pnsn/mcEmeter/IMG_4341.JPG

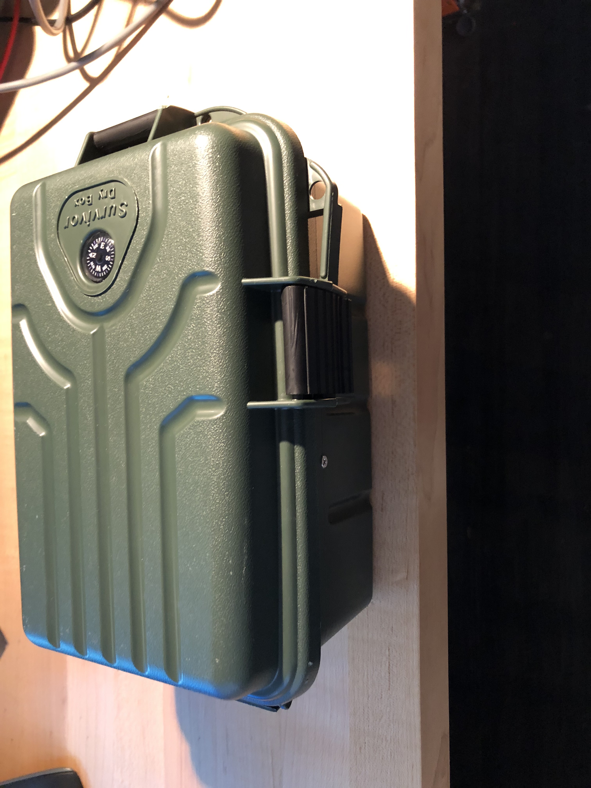
IMG_4341.JPG
