pnsn/mcEmeter/IMG_4349.JPG

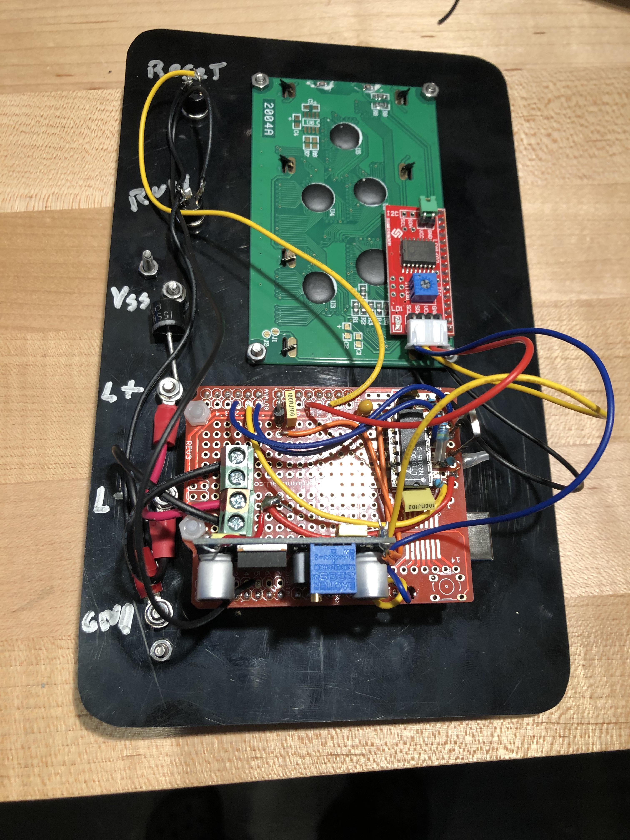
IMG_4349.JPG
