pnsn/mcEmeter/mcemeter_plate.pdf

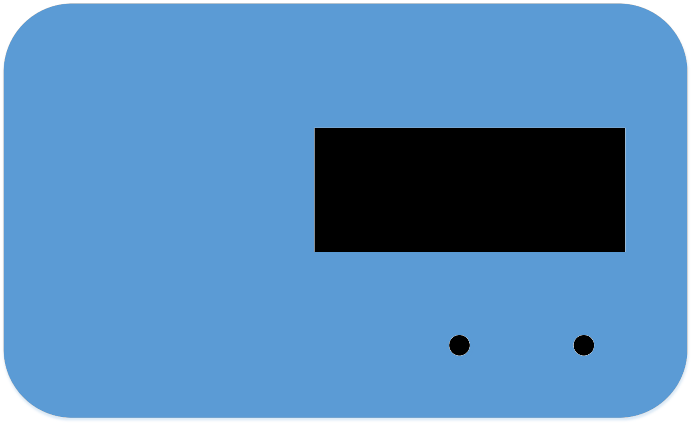
[picture p5: figure]
