pnsn/mcEmeter/IMG_4340.JPG

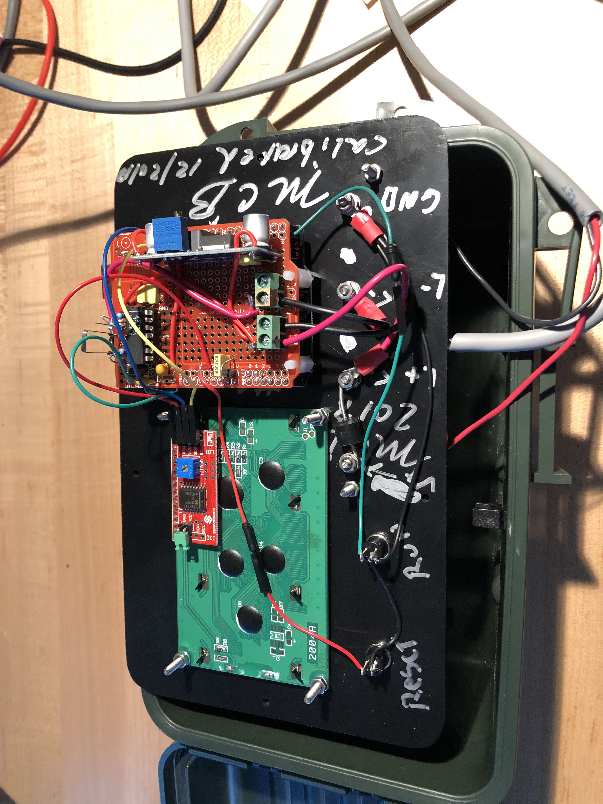
IMG_4340.JPG
