pnsn/mcEmeter/IMG_4350.JPG

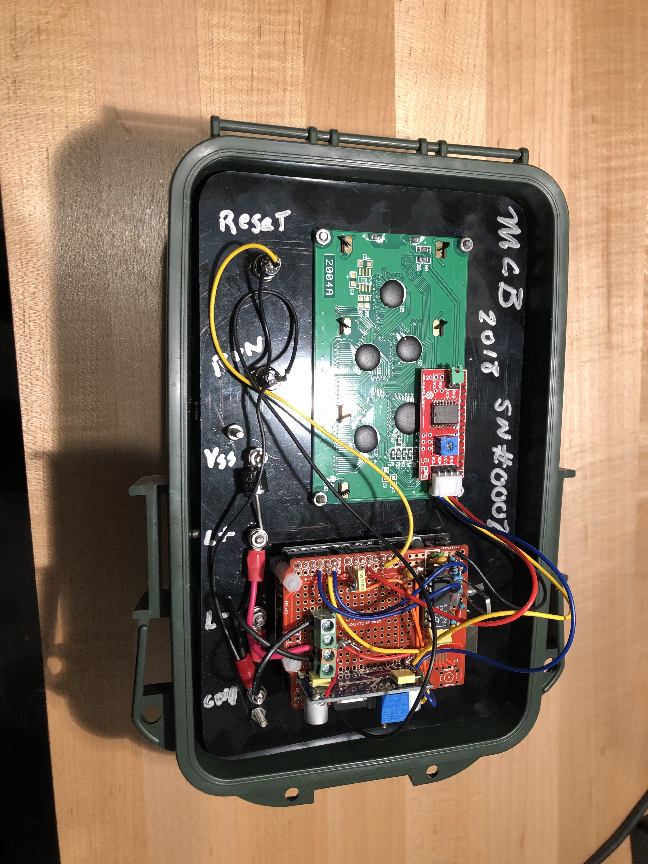
IMG_4350.JPG
