pnsn/mcEmeter/mcemeter_Rev1.0.bmp

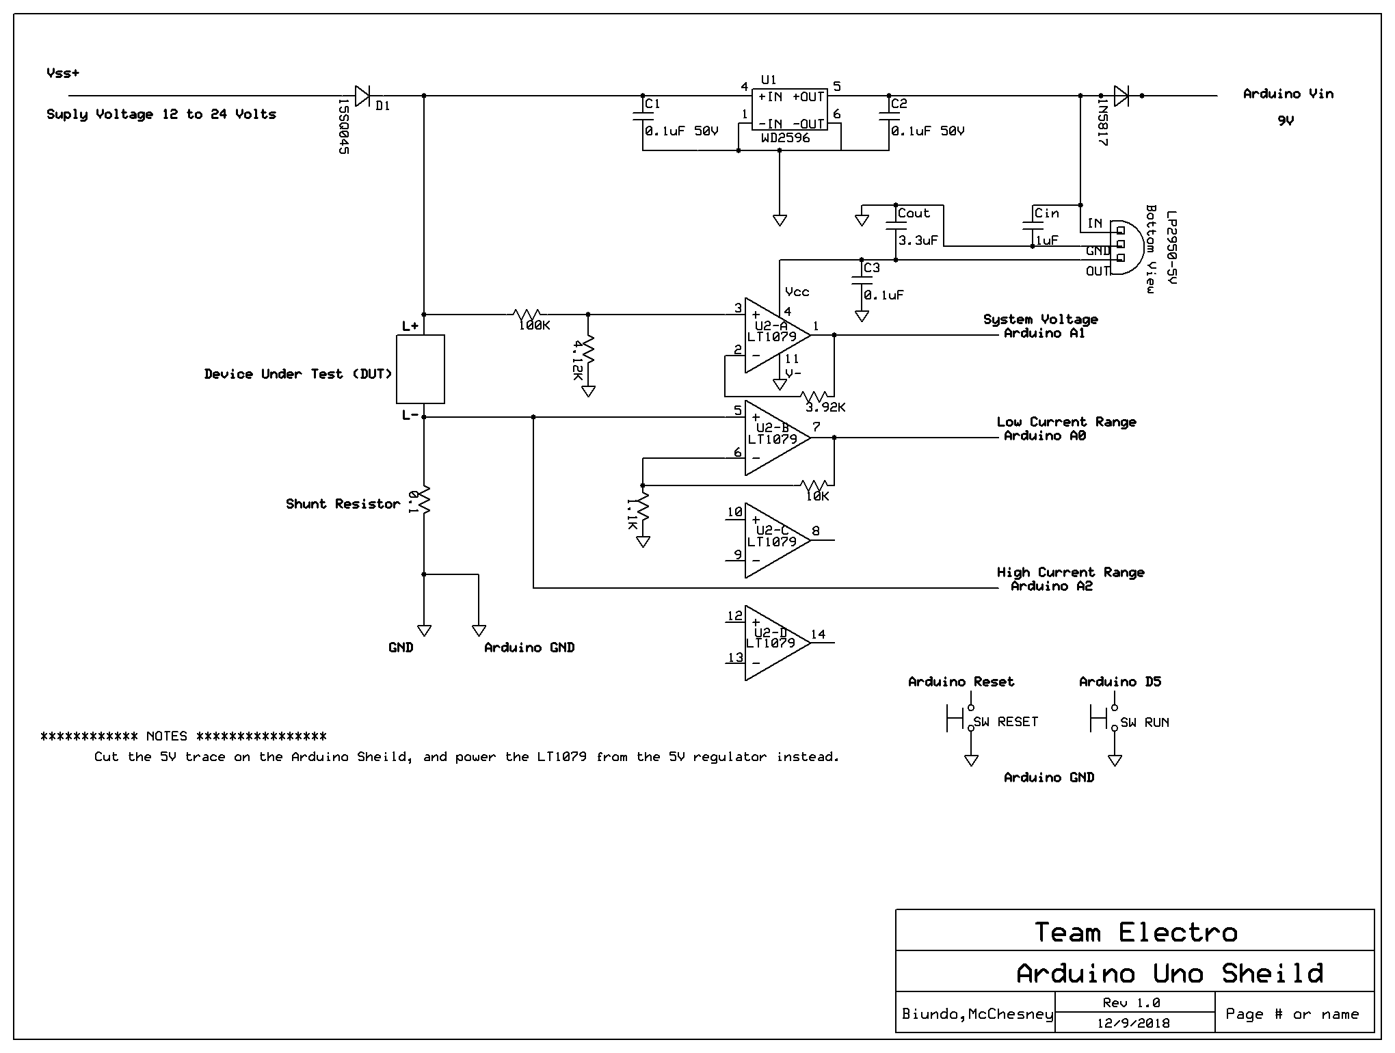
mcemeter_Rev1.0.bmp
