pnsn/mcEmeter/mcEmeterCalSetUp.jpg

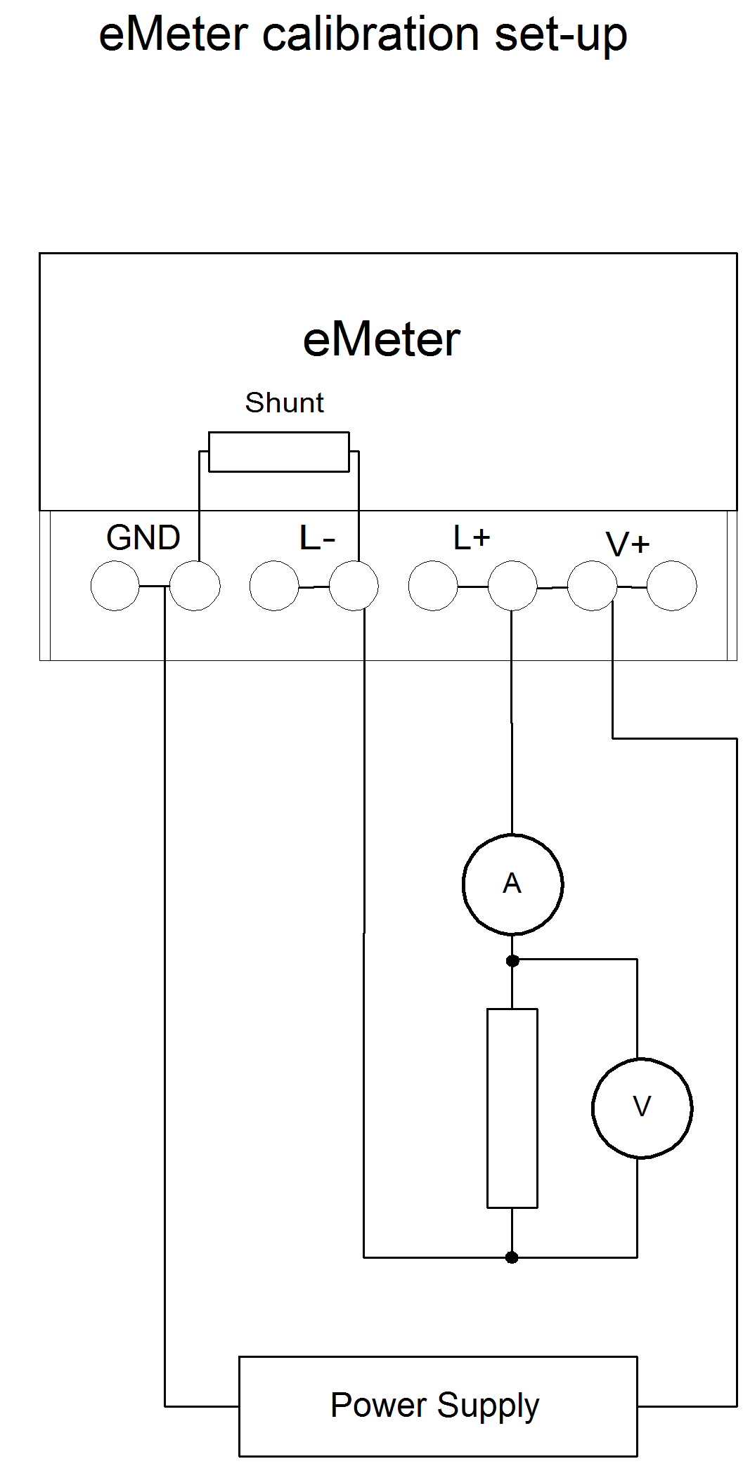
mcEmeterCalSetUp.jpg
