pnsn/mcEmeter/(commit log)

2018-12-12 Arduino Uno Sheild Express PCB Schematic
2018-12-12 CNC Original PDF of Plate
    Screen and Push Button Switch holes.
    Panel dims: 5x8.25"
    Screen hole dims: 1.58x3.85"
    Push button holes: .275"
2018-12-12 ExpressSCH Schematic File
    [mcemeter_Rev1.0.sch]
2018-12-16 mcEmeter Arduino code pre-calibration of unit SN 0001
2018-12-16 Calibration Routine
    Calibration routine measures voltage and current for comparison against values
    measured by other instruments so scale factors, sfV and sfI, can be determined
    to produce agreement. An accurate value of the board current measuring resistor
    and the Arduino 1.1V ADC reference should be entered under GLOBAL VARIABLES.
2018-12-16 Calibration Setup Schematic Image
2018-12-16 Calibration program
    mcEmeterCalibratin.ino is a calibration program for the
    dual-current-range mcEmeter.
    It runs on the Arduino monitor.
2018-12-20 sn # 0001 with calibration settings.
    float vRef = 1.097 ; // measured ADC reference voltage
    float sfI1 = .8984 ; // current1 calibration scale-factor
    float sfI2 = 9.891; // current1 calibration scale-factor
    float sfV = 26.623 ; // voltage calibration scale-factor
    float shunt = 0.0989; // measurement shunt value
2018-12-20 sn #0001 with calibration settings
    float vRef = 1.097 ; // measured ADC reference voltage for Uno 3
    float sfV = 26.623 ; // (25 default) Input voltage calibration scale-factor (Vin/Vout)
    float sfI1 = .8984 ; // (1 default) Input current calibration scale-factor (Ain/Vout)
    float sfI2 = 9.891 ; // (10 default )Input current calibration scale-factor (Ain/Vout)
    float shunt = 0.0989 ; // measurement shunt value (0 for probe)
2018-12-21 sn #0001 photos
    Bench final turn on photos. Unit calibrated and measuring a Sierra Wireless Cell Modem.
2018-12-25 Schematic Notes
    Added pin-out instructions for 5V regulator... Don't put it in backwards;)
2018-12-25 Schematic Notes
    Added notes for 5V regulator, no wiring changes.
2018-12-25 Added Notes.
    5V regulator details.
